SamoaChen/2-Linkages-Robotic-Arm-Hybrid-Position-Force-Control/images/Arm_Display_Final.JPG

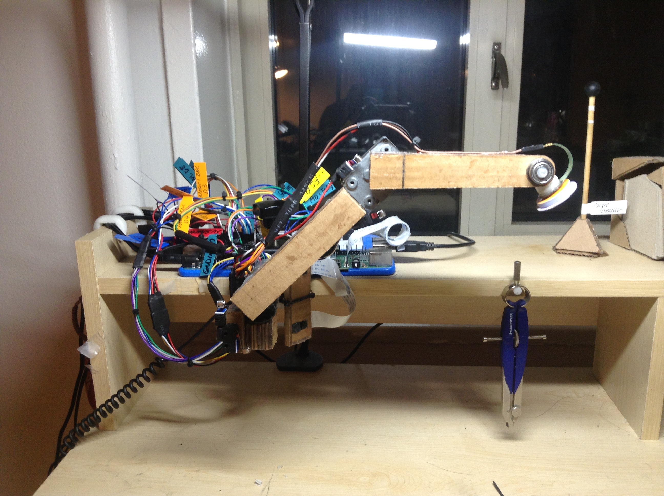
images/Arm_Display_Final.JPG
