SamoaChen/2-Linkages-Robotic-Arm-Hybrid-Position-Force-Control/images/Arm_Display_Final_with_Curtain.JPG

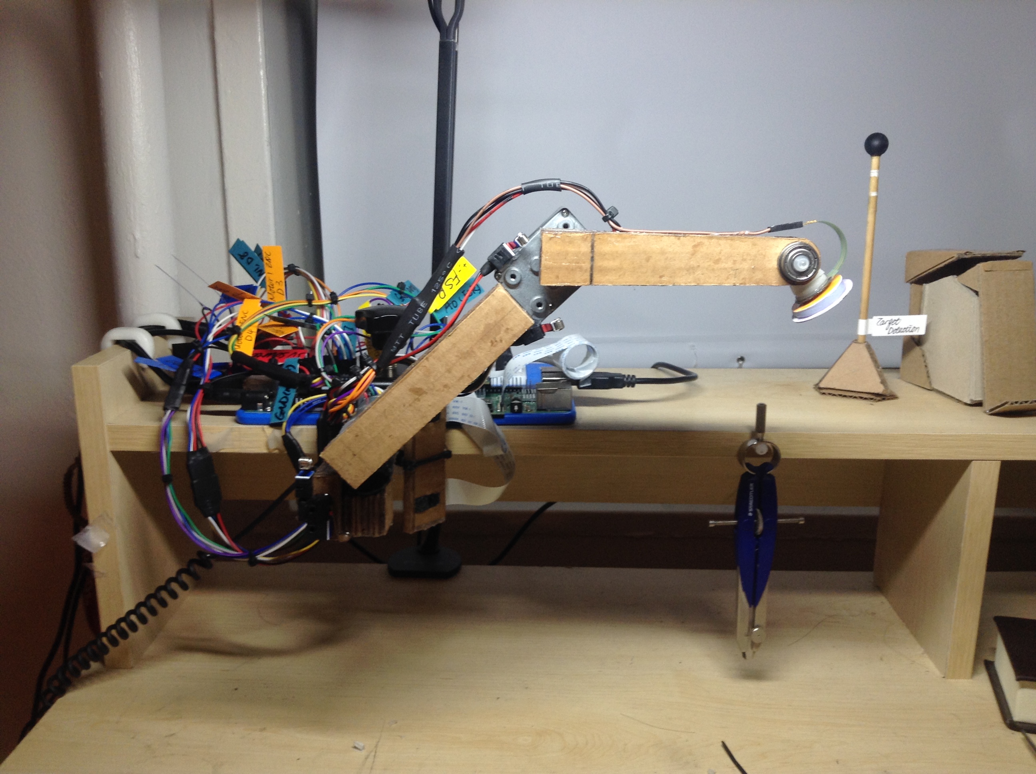
images/Arm_Display_Final_with_Curtain.JPG
