SamoaChen/2-Linkages-Robotic-Arm-Hybrid-Position-Force-Control/images/Backside_Arm_2.JPG

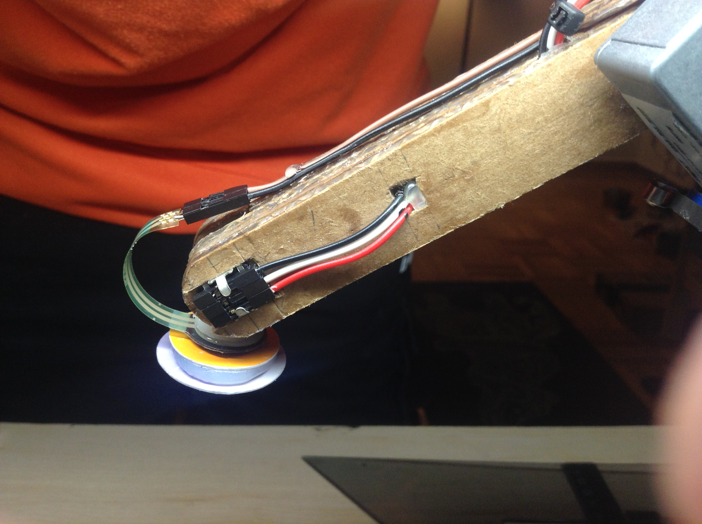
images/Backside_Arm_2.JPG
