SamoaChen/2-Linkages-Robotic-Arm-Hybrid-Position-Force-Control/images/Base.JPG

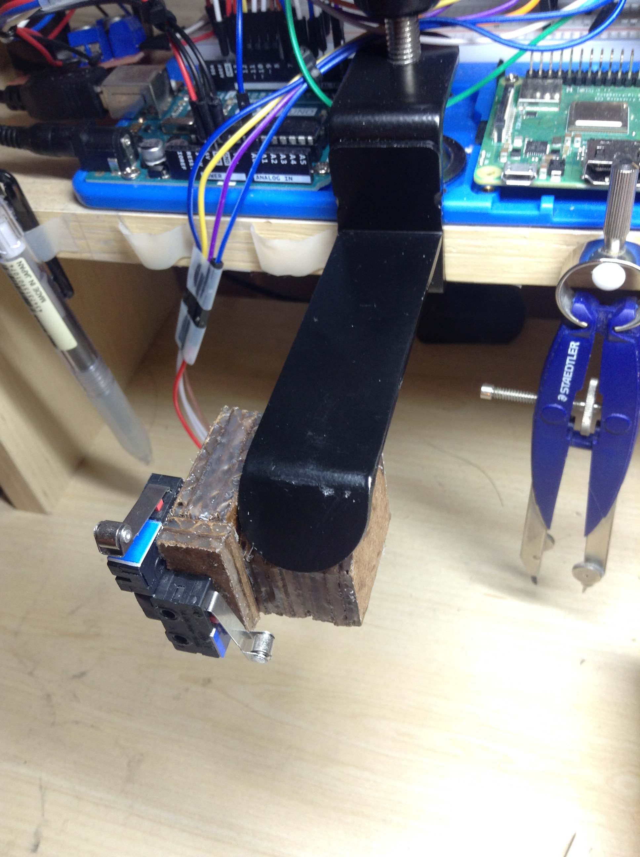
images/Base.JPG
