SamoaChen/2-Linkages-Robotic-Arm-Hybrid-Position-Force-Control/images/IMG_3159.JPG

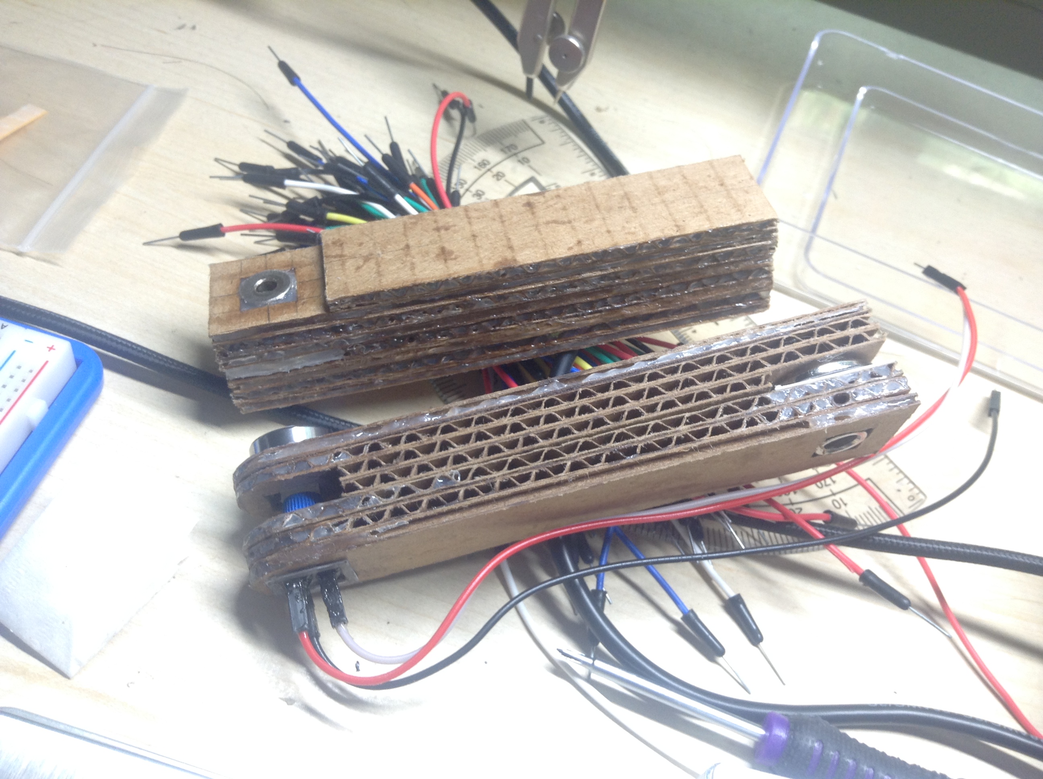
images/IMG_3159.JPG
