SamoaChen/2-Linkages-Robotic-Arm-Hybrid-Position-Force-Control/images/Malfunction.JPG

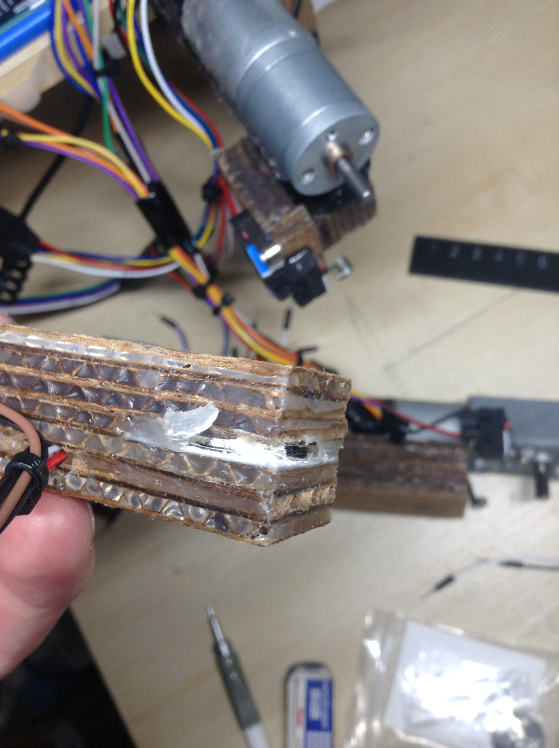
images/Malfunction.JPG
