SamoaChen/2-Linkages-Robotic-Arm-Hybrid-Position-Force-Control/images/New_Second_Arm_Interior.JPG

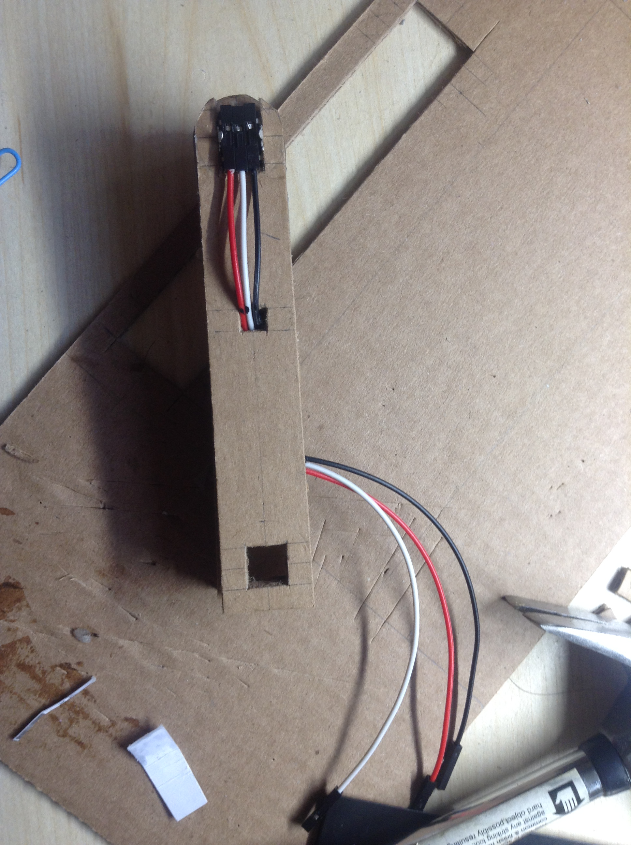
images/New_Second_Arm_Interior.JPG
