SamoaChen/2-Linkages-Robotic-Arm-Hybrid-Position-Force-Control/images/Stereo_Camera_4.JPG

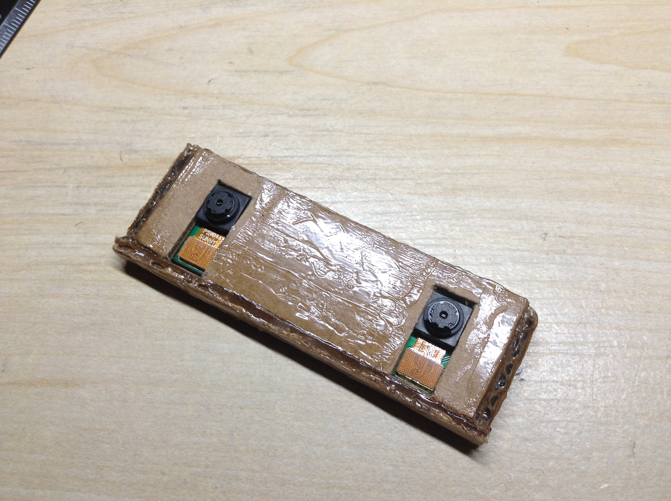
images/Stereo_Camera_4.JPG
