SamoaChen/2-Linkages-Robotic-Arm-Hybrid-Position-Force-Control/Python/ball_tracing/camera_up.jpg

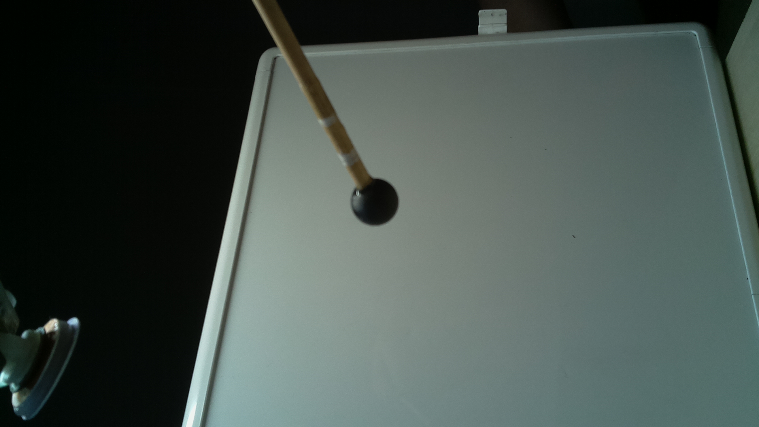
Python/ball_tracing/camera_up.jpg
