SamoaChen/2-Linkages-Robotic-Arm-Hybrid-Position-Force-Control/images/Arm_Assembled.JPG

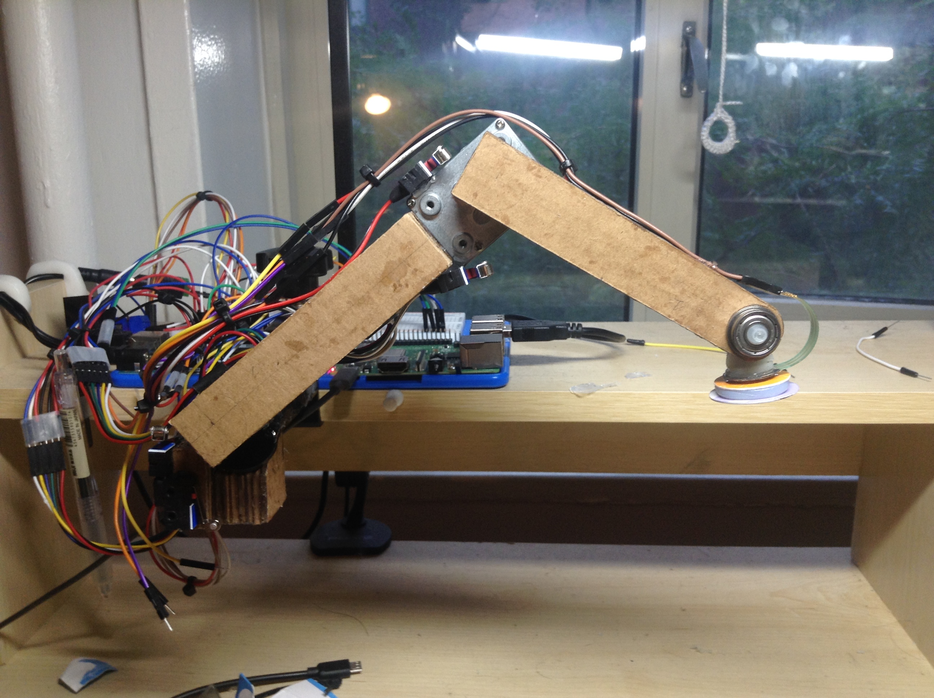
images/Arm_Assembled.JPG
