SamoaChen/2-Linkages-Robotic-Arm-Hybrid-Position-Force-Control/images/Checker_Board_Measure.JPG

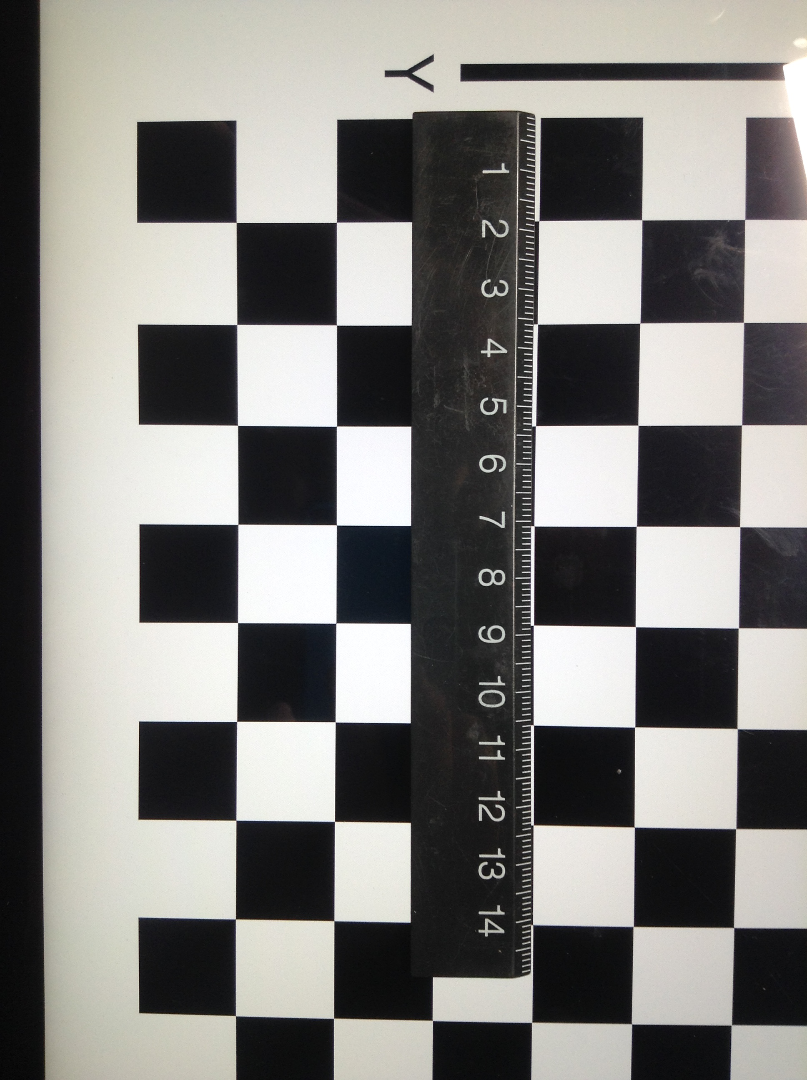
images/Checker_Board_Measure.JPG
