SamoaChen/2-Linkages-Robotic-Arm-Hybrid-Position-Force-Control/images/Repair_Arm_2.JPG

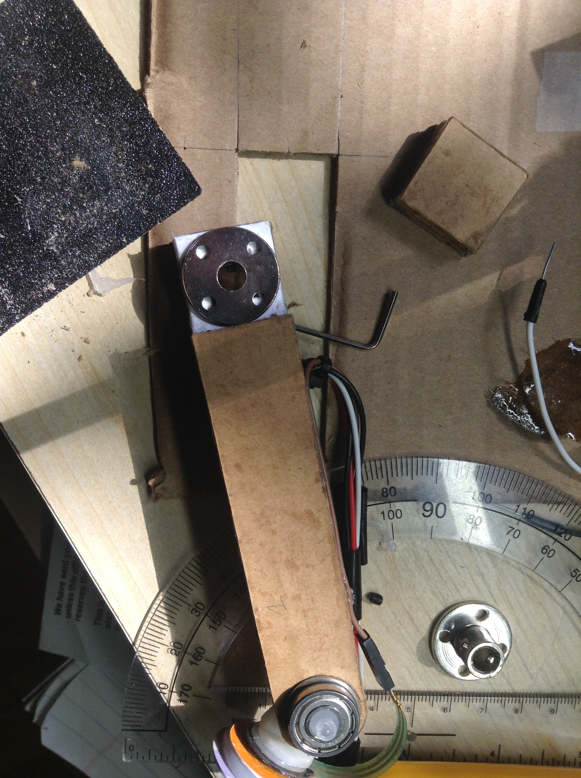
images/Repair_Arm_2.JPG
