SamoaChen/2-Linkages-Robotic-Arm-Hybrid-Position-Force-Control/Python/ball_tracing/waiting.py

import time

def waiting(start,division):
    end=time.perf_counter()
    duration=end-start
    duration_desired=1/division
    if duration<duration_desired:
        time.sleep(duration_desired-duration)
