SamoaChen/2-Linkages-Robotic-Arm-Hybrid-Position-Force-Control/(commit log)

2020-07-29 Update README.md
    add equipment and material requirement
2020-10-16 Add files via upload
    Arduino side code
